UnHolds/FsInf-Control/Housing/Housing.FCStd

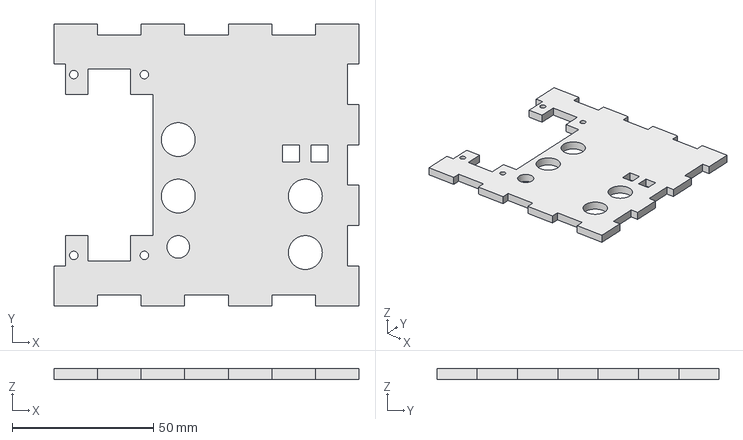
[picture p1: CAD file, 2024-05-20]
Housing/Housing.FCStd
108.0 x 100.0 x 4.00 mm
