UnHolds/FsInf-Control/PCB/IsItOpen.kicad_pcb

## KiCad design PCB/IsItOpen.kicad_pcb (2024-05-18)

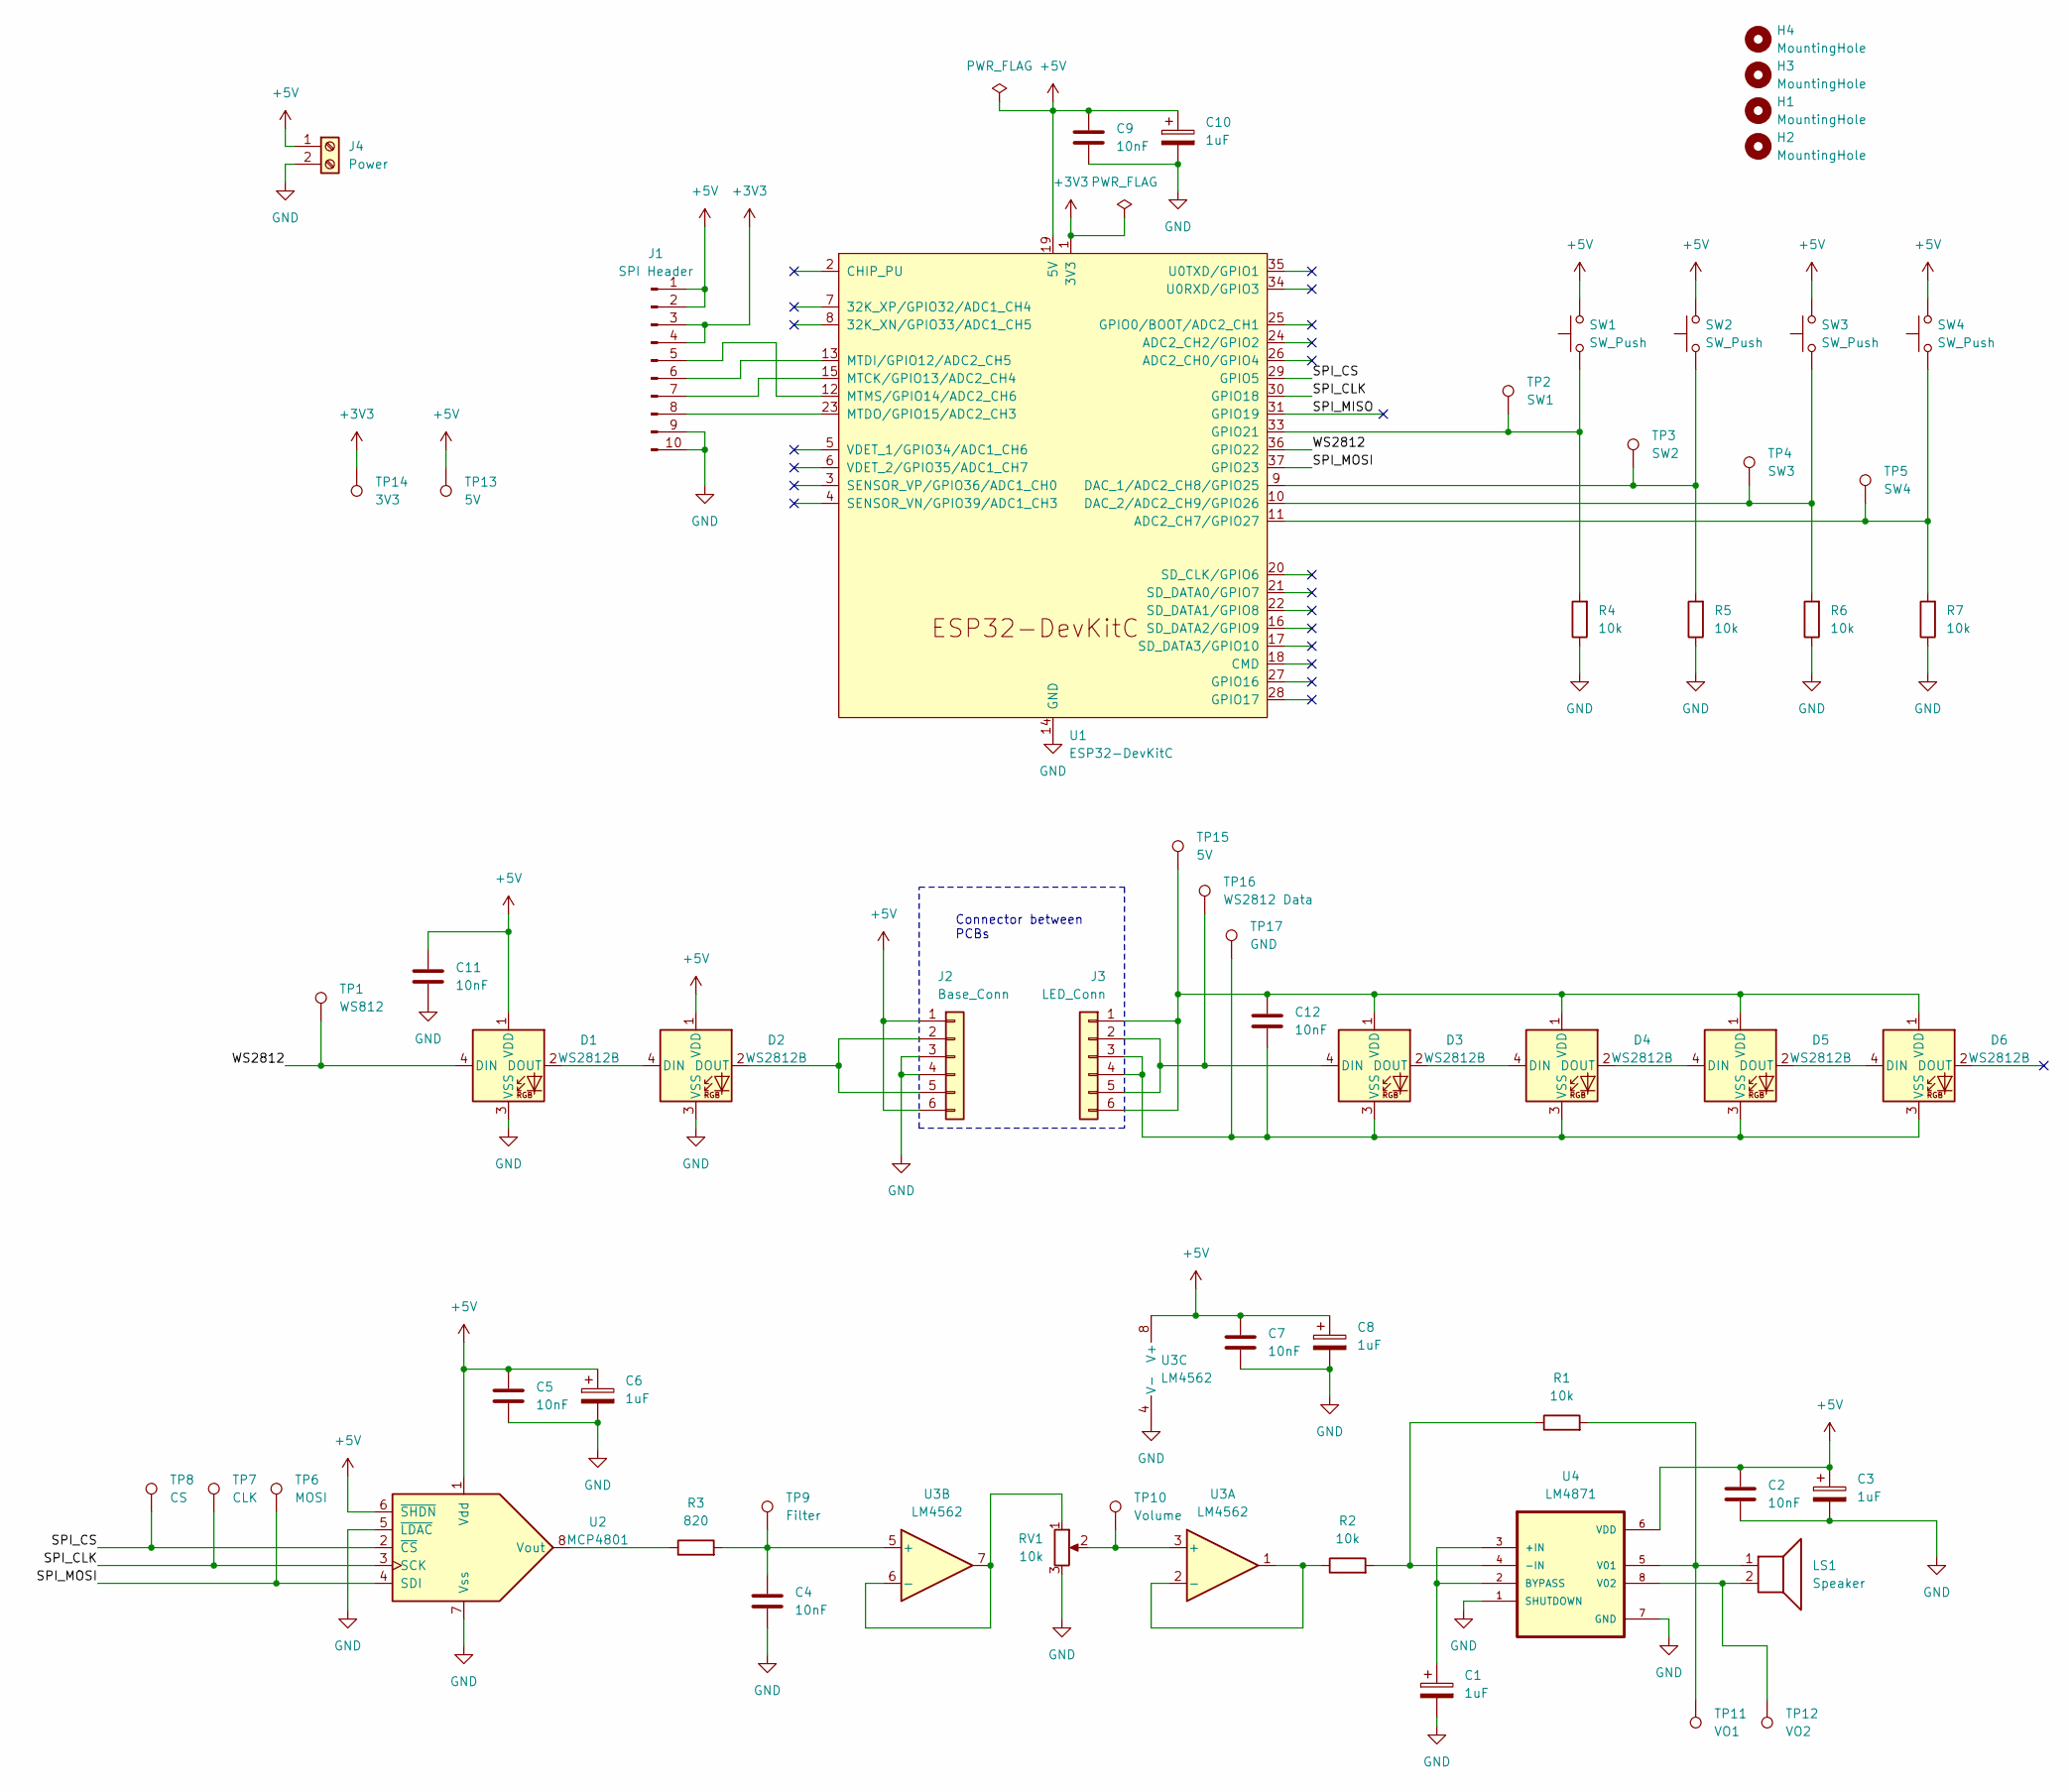
[picture p2: schematic IsItOpen.kicad_sch, FsInf Control]

Parts:
C1, C3, C6, C8, C10: 1uF; CP_Radial_D5.0mm_P2.50mm
C2, C4, C5, C7, C9, C11, C12: 10nF; C_1206_3216Metric_Pad1.33x1.80mm_HandSolder
D1, D2, D3, D4, D5, D6: WS2812B; LED_WS2812B_PLCC4_5.0x5.0mm_P3.2mm
H1, H2, H3, H4: MountingHole; MountingHole_3.2mm_M3
J1: SPI Header; PinHeader_1x10_P2.54mm_Vertical
J2: Base_Conn; BasePCB
J3: LED_Conn; LedPCB
J4: Power; TerminalBlock_MetzConnect_Type055_RT01502HDWU_1x02_P5.00mm_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
LS1: Speaker; PinHeader_1x02_P2.54mm_Vertical
R1, R2, R4, R5, R6, R7: 10k; R_0805_2012Metric_Pad1.20x1.40mm_HandSolder
R3: 820; R_0805_2012Metric_Pad1.20x1.40mm_HandSolder
RV1: 10k; Potentiometer_Piher_PT-6-V_Vertical
SW1, SW2, SW3, SW4: SW_Push; PinHeader_1x02_P2.54mm_Vertical
TP1: WS812; TestPoint_Pad_D3.0mm
TP2: SW1; TestPoint_Pad_D3.0mm
TP3: SW2; TestPoint_Pad_D3.0mm
TP4: SW3; TestPoint_Pad_D3.0mm
TP5: SW4; TestPoint_Pad_D3.0mm
TP6: MOSI; TestPoint_Pad_D3.0mm
TP7: CLK; TestPoint_Pad_D3.0mm
TP8: CS; TestPoint_Pad_D3.0mm
TP9: Filter; TestPoint_Pad_D3.0mm
TP10: Volume; TestPoint_Pad_D3.0mm
TP11: VO1; TestPoint_Pad_D3.0mm
TP12: VO2; TestPoint_Pad_D3.0mm
TP13, TP15: 5V; TestPoint_Pad_D3.0mm
TP14: 3V3; TestPoint_Pad_D3.0mm
TP16: WS2812 Data; TestPoint_Pad_D3.0mm
TP17: GND; TestPoint_Pad_D3.0mm
U1: ESP32-DevKitC
U2: MCP4801; DIP-8_W7.62mm
U3: LM4562; DIP-8_W7.62mm
U4: LM4871; SOIC-8_5.23x5.23mm_P1.27mm

Connections:
+3V3: J1.3, J1.4, TP14.1, U1.1 (3V3)
+5V: C2.1, C3.1, C5.1, C6.1, C7.1, C8.1, C9.1, C10.1, C11.1, D1.1 (VDD), D2.1 (VDD), J1.1, J1.2, J2.1, J2.6, J4.1, SW1.2, SW2.2, SW3.2, SW4.2, TP13.1, U1.19 (5V), U2.1 (Vdd), U2.6 (~SHDN), U3.8 (V+), U4.6 (VDD); also elsewhere on the board
/SPI_CLK: TP7.1, U1.30 (GPIO18), U2.3 (SCK)
/SPI_CS: TP8.1, U1.29 (GPIO5), U2.2 (~CS)
/SPI_MISO: U1.31 (GPIO19)
/SPI_MOSI: TP6.1, U1.37 (GPIO23), U2.4 (SDI)
/WS2812: D1.4 (DIN), TP1.1, U1.36 (GPIO22)
GND: C1.2, C2.2, C3.2, C4.2, C5.2, C6.2, C7.2, C8.2, C9.2, C10.2, C11.2, D1.3 (VSS), D2.3 (VSS), J1.9, J1.10, J2.3, J2.4, J4.2, R4.1, R5.1, R6.1, R7.1, RV1.3, U1.14 (GND), U1.32 (GND), U1.38 (GND), U2.5 (~LDAC), U2.7 (Vss), U3.4 (V-), U4.1 (SHUTDOWN), U4.7 (GND); also elsewhere on the board
unnamed: D1.2 (DOUT), D2.4 (DIN)
unnamed 9: D2.2 (DOUT), J2.2, J2.5; also elsewhere on the board
unnamed: D3.4 (DIN), J3.2, J3.5, TP16.1
unnamed: D3.2 (DOUT), D4.4 (DIN)
unnamed: C12.1, D3.1 (VDD), D4.1 (VDD), D5.1 (VDD), D6.1 (VDD), J3.1, J3.6, TP15.1
unnamed: C12.2, D3.3 (VSS), D4.3 (VSS), D5.3 (VSS), D6.3 (VSS), J3.3, J3.4, TP17.1
unnamed: D4.2 (DOUT), D5.4 (DIN)
unnamed: D5.2 (DOUT), D6.4 (DIN)
unnamed: J1.5, U1.12 (MTMS/GPIO14/ADC2_CH6)
unnamed: J1.6, U1.13 (MTDI/GPIO12/ADC2_CH5)
unnamed: J1.7, U1.15 (MTCK/GPIO13/ADC2_CH4)
unnamed: J1.8, U1.23 (MTDO/GPIO15/ADC2_CH3)
unnamed: R7.2, SW4.1, TP5.1, U1.11 (ADC2_CH7/GPIO27)
unnamed: R5.2, SW2.1, TP3.1, U1.9 (DAC_1/ADC2_CH8/GPIO25)
unnamed: R6.2, SW3.1, TP4.1, U1.10 (DAC_2/ADC2_CH9/GPIO26)
unnamed: R4.2, SW1.1, TP2.1, U1.33 (GPIO21)
unnamed: R3.1, U2.8 (Vout)
unnamed: RV1.2, TP10.1, U3.3 (+)
unnamed: R2.1, U3.1, U3.2 (-)
unnamed: C4.1, R3.2, TP9.1, U3.5 (+)
unnamed: RV1.1, U3.6 (-), U3.7
unnamed: C1.1, U4.2 (BYPASS), U4.3 (+IN)
unnamed: R1.1, R2.2, U4.4 (-IN)
unnamed: LS1.1, R1.2, TP11.1, U4.5 (V01)
unnamed: LS1.2, TP12.1, U4.8 (V02)

Notes on the sheet:
Connector between PCBs

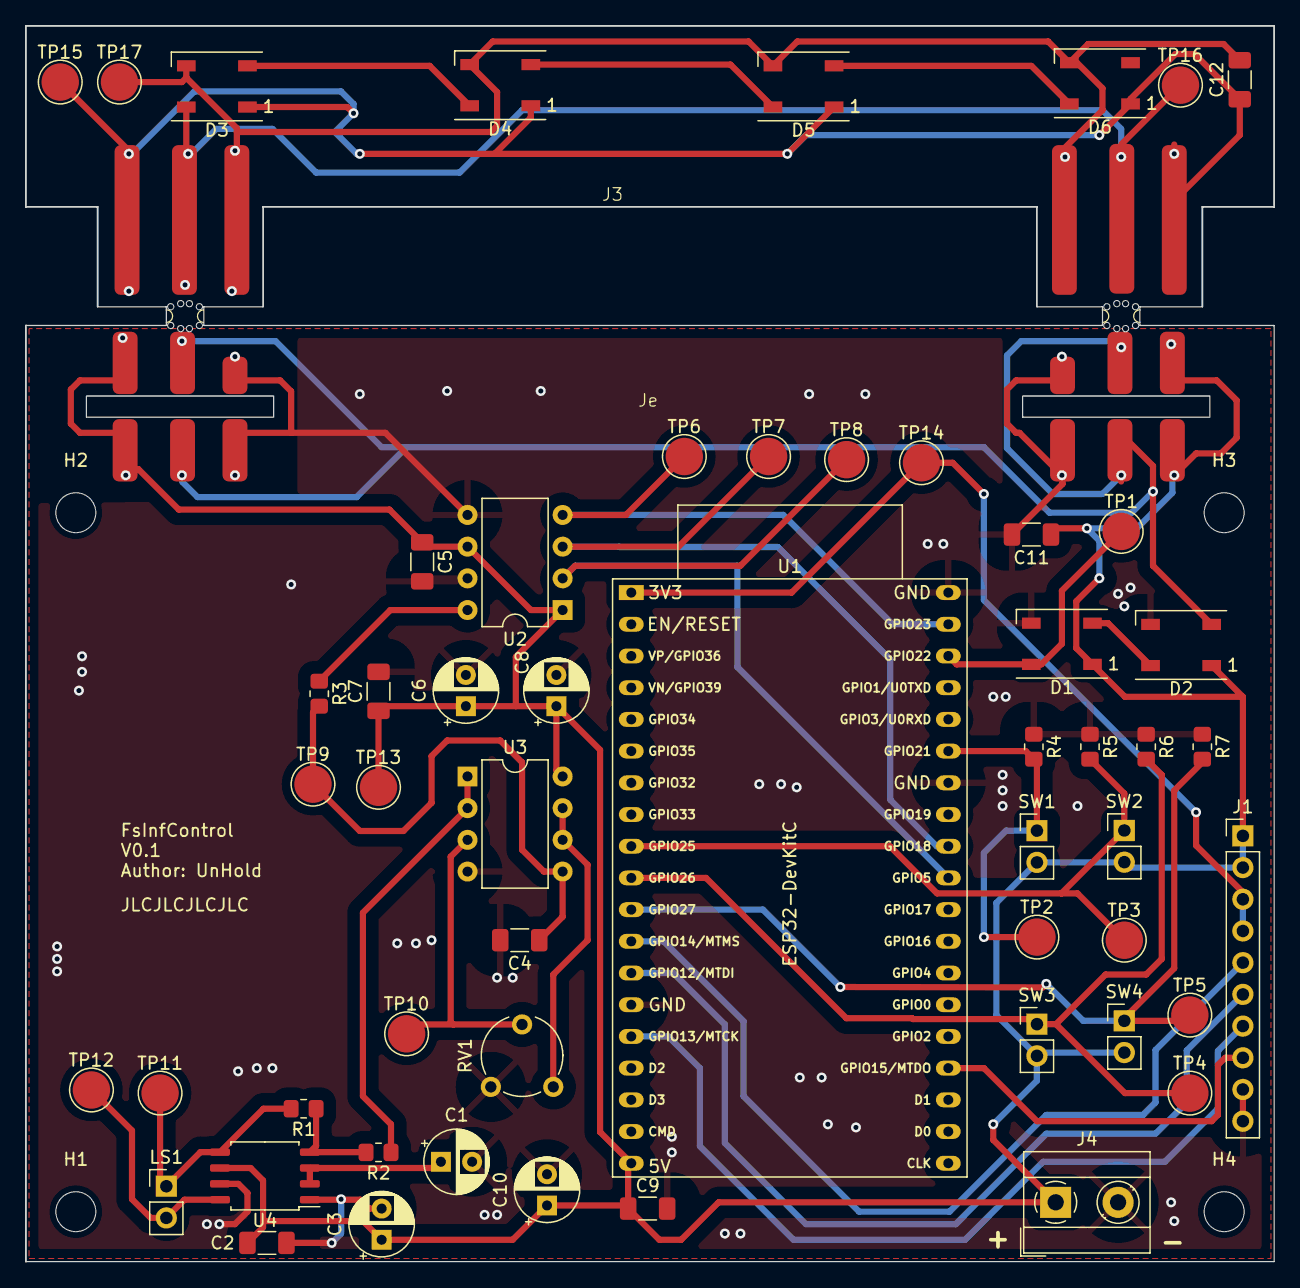
[picture p3: board IsItOpen.kicad_pcb from above]

Board: 2 copper layers, 100.0 x 99.0 mm, 62 parts (0 on the bottom side), 32 nets.

Other parts of the board:
Je: Base_Conn; BasePCB
mouse-bite-1mm-slot, mouse-bite-1mm-slot#2: VAL**; mouse-bite-1mm-slot

Their connections:
+5V: Je.1, Je.6; also elsewhere on the board
GND: Je.3, Je.4; also elsewhere on the board
unnamed 9: Je.2, Je.5; also elsewhere on the board
