UnHolds/FsInf-Control/(commit log)

2024-03-29 Added inital schematic
    [IsItOpen.kicad_pcb, IsItOpen.kicad_sch]
2024-03-30 added pcb connector
    [IsItOpen.kicad_sch]
2024-04-20 added footprint for pcb connector
    [IsItOpen.kicad_sch]
2024-04-20 added basic pcb layout
    [IsItOpen.kicad_pcb, IsItOpen.kicad_sch]
2024-04-28 routed pcbn
    [IsItOpen.kicad_pcb, IsItOpen.kicad_sch]
2024-05-18 fixed footprint + connected unconnected items
    [IsItOpen.kicad_pcb]
2024-05-18 added plots
    [IsItOpen-B_Cu.gbl, IsItOpen-B_Mask.gbs, IsItOpen-B_Paste.gbp, IsItOpen-B_Silkscreen.gbo, IsItOpen-Edge_Cuts.gm1, IsItOpen-F_Cu.gtl, IsItOpen-F_Mask.gts, IsItOpen-F_Paste.gtp]
2024-05-18 renamend kicad
    [IsItOpen-B_Cu.gbl, IsItOpen-B_Mask.gbs, IsItOpen-B_Paste.gbp, IsItOpen-B_Silkscreen.gbo, IsItOpen-Edge_Cuts.gm1, IsItOpen-F_Cu.gtl, IsItOpen-F_Mask.gts, IsItOpen-F_Paste.gtp]
2024-05-18 added cad file for the housing
    [Housing.FCStd]
2024-05-19 added export for v1 + gitignore
    [Housing.FCStd]
2024-05-20 removed wrong export file + update
    [Housing.FCStd]
2024-06-25 fixed small bug in serial read
    [main.cpp]
2024-06-26 added dim via UART + added shdn for speaker
2024-06-27 mattermost support, replace " -> ', http errorcodes responses
    [main.py]
2024-06-28 disabled sleep (brakes uart read)
