UnHolds/FsInf-Control/(notices)

Notices in the files:
PCB/IsItOpen.kicad_sch:
License: CERN-OHL-S
